bandarusrimanirishit/Three-Band-Graphic-Equalizer/project_demo.asc

C1: cap; {Ca}
C2: cap; {Ca}
C3: cap; {Cb}
C4: cap; {Cb}
C5: cap; {Cb}
C6: cap; {Cb}
C7: cap; 0.1µ
C8: cap; 1µ
C9: cap; 1n
C10: cap; 1µ
C11: cap; 1n
C12: cap; 1µ
C13: cap; 1µ
C14: cap; 1µ
C15: cap; 1µ
R1: res; {R1a}
R2: res; {R3a}
R3: res; {R2a}
R4: res; 5k
R5: res; 5k
R6: res; {R1b}
R7: res; {R3b}
R8: res; {R2b}
R9: res; {R1c}
R10: res; {R3c}
R11: res; {R2c}
R12: res; 620k
R13: res; 620k
R14: res; 50
R15: res; 2.5k
R16: res; 1k
R17: res; 900
R18: res; 10k
R19: res; 10
R20: res; 50
R21: res; 50
R22: res; 50
R23: res; 1k
R24: res; 1k
R25: res; 1k
R26: res; 1k
U1: UniversalOpAmp2
U2: UniversalOpAmp2
U3: UniversalOpAmp2
U4: AD8648
U5: AD8648
U6: AD8648
V1: voltage; 5
V2: voltage; SINE(2.5 1 1300)
V3: voltage; SINE(2.5 1 285)
V4: voltage; SINE(2,5 1 60)
Named nets: 0, Vcom, Vdd, Vin_audio3, Vin_audio, Vout, Vin_audio1, Vin_audio2
.param R1a=20k R2a=40k R3a=160k Ca=100n R1b=4k R2b=9k R3b=30k Cb=0.1u R1c=1k R2c=2k R3c=3k
voltage buffer
stage 1 bandpass filter fo=60hz bandwidth=80hz
stage 2 bandpass filter fo=280hz bandwidth=370hz
stage 3 bandpass filter fo=1200hz bandwidth=1470hz
Adder
.tran 30m
power supply
simulated audio source
Bandaru Srimani Rishit 23f3000436
Harsha vardhan 23f3000126
Sivaraman s
